Doenec/ecg-esp32/WhatsApp Image 2024-11-03 at 2.57.34 PM.jpeg

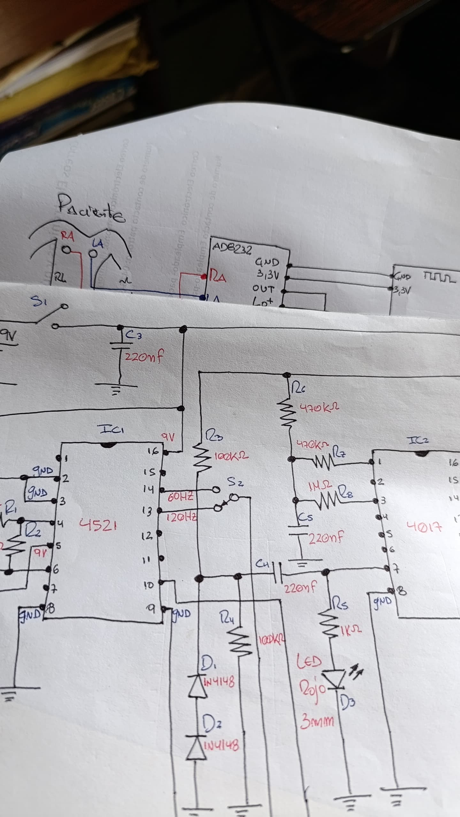
WhatsApp Image 2024-11-03 at 2.57.34 PM.jpeg
