Doenec/ecg-esp32/ECG V-0.2.jpg

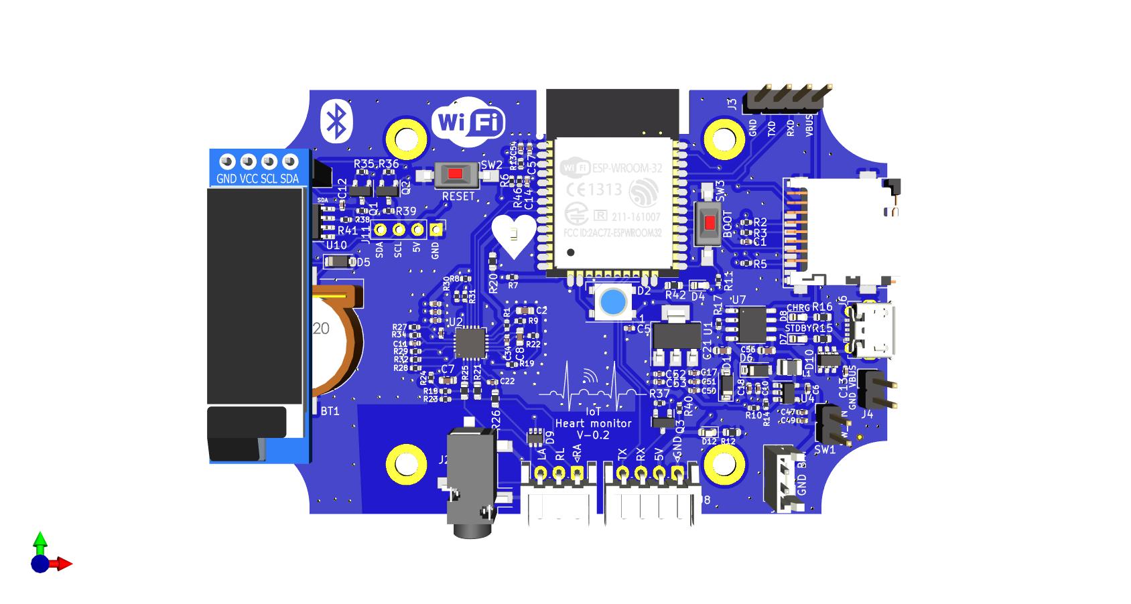
ECG V-0.2.jpg
