Doenec/ecg-esp32/ECG V-0.24.jpg

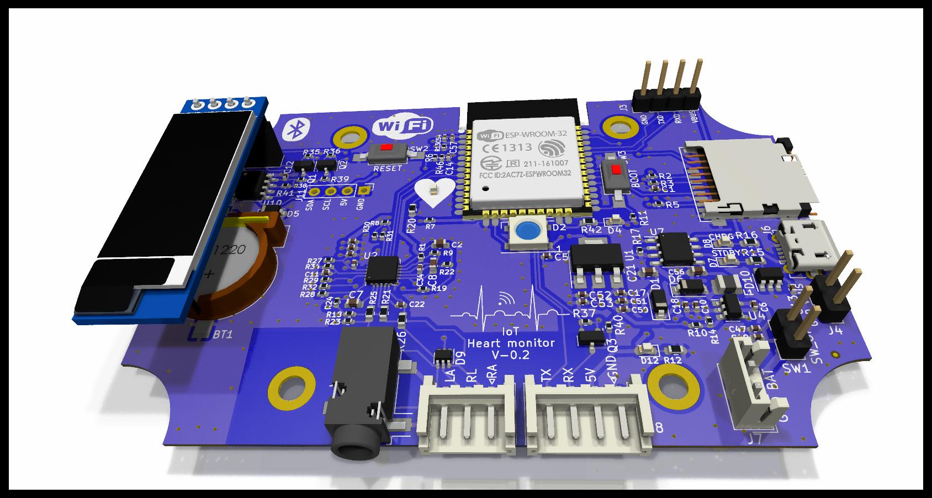
ECG V-0.24.jpg
