Doenec/ecg-esp32/untitled2.png

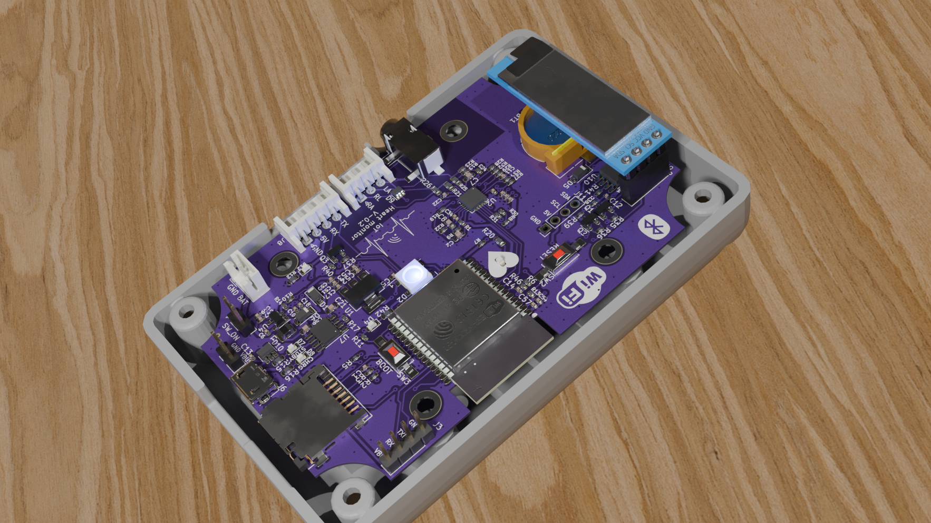
untitled2.png
