Doenec/ecg-esp32/untitled3.png

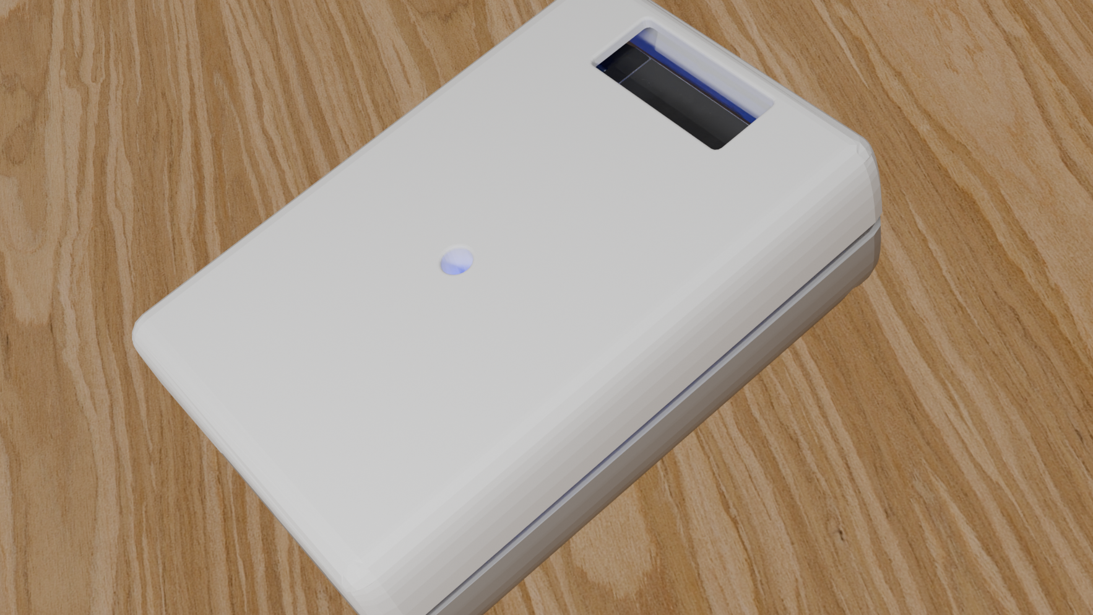
untitled3.png
