Doenec/ecg-esp32/untitled.png

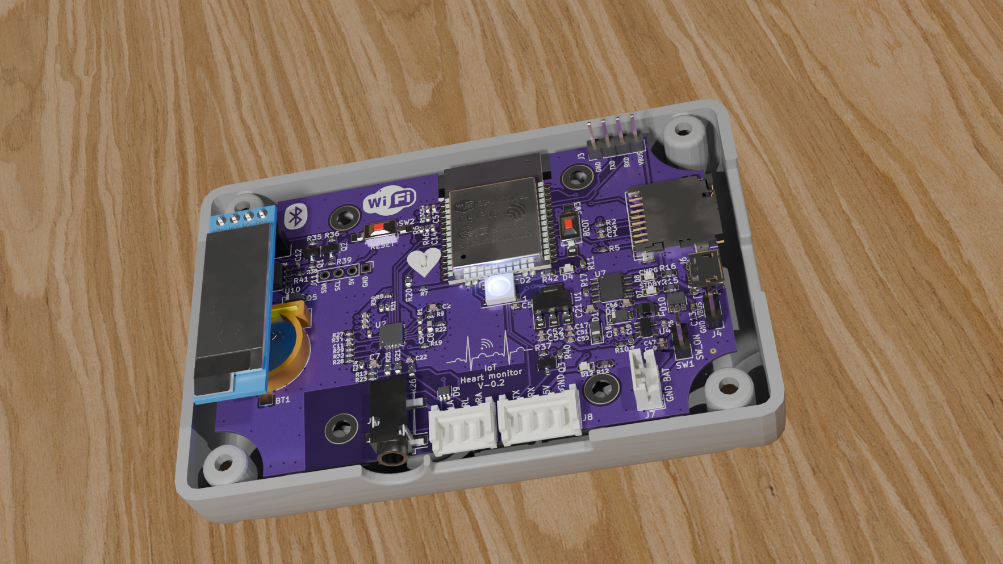
untitled.png
