Doenec/ecg-esp32/WhatsApp Image 2024-11-03 at 3.13.52 PM.jpeg

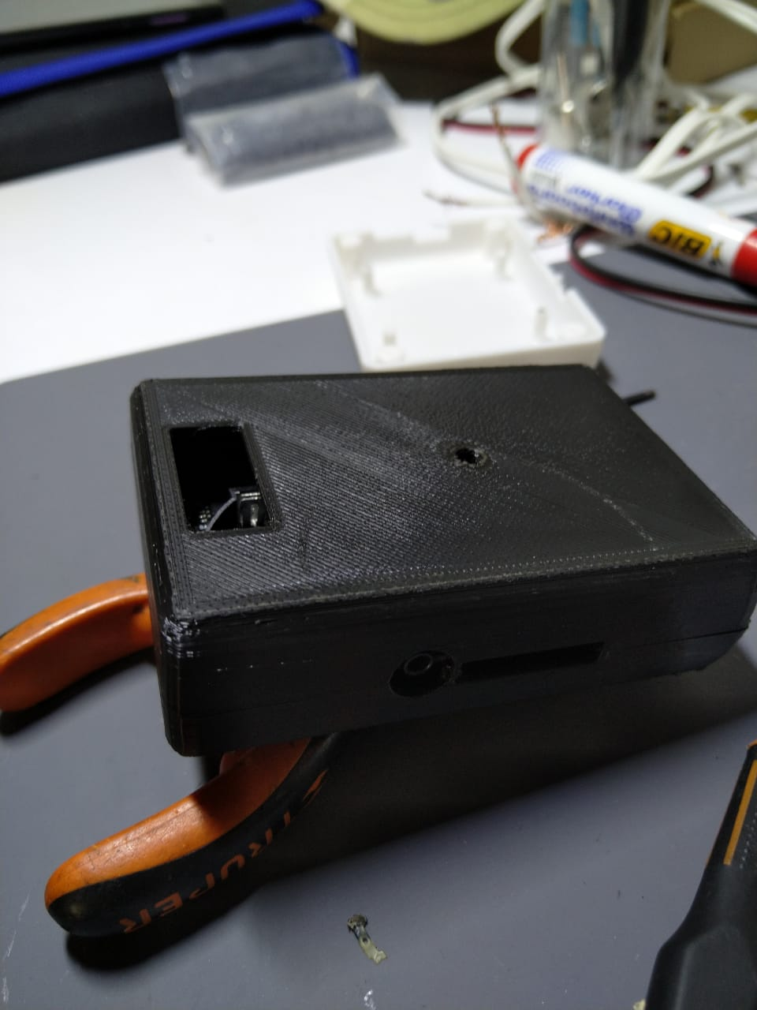
WhatsApp Image 2024-11-03 at 3.13.52 PM.jpeg
