Doenec/ecg-esp32/lower case ECG 8-1-23.STL

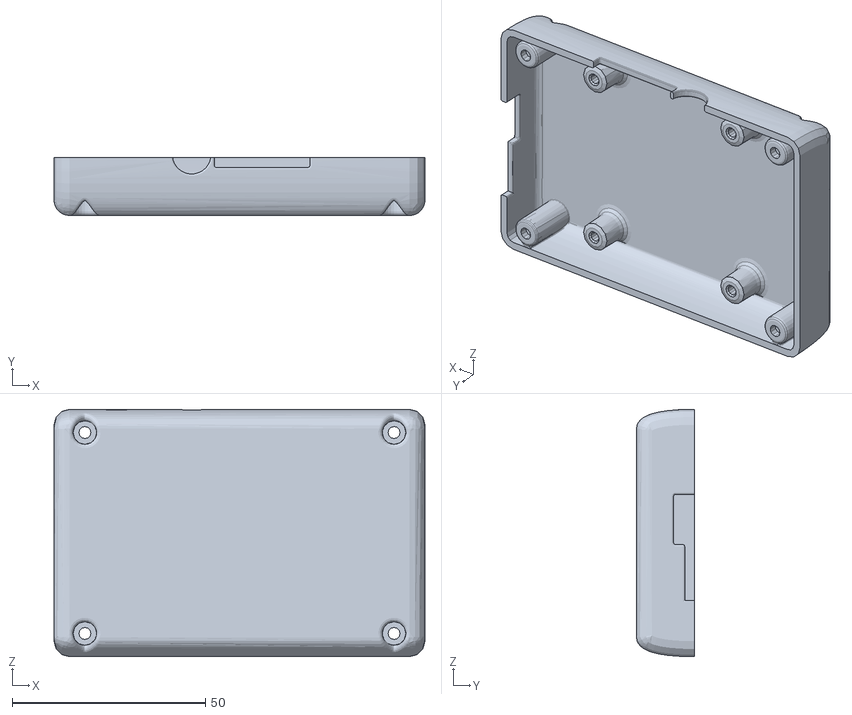
[picture p11: CAD file, 2024-11-03]
lower case ECG 8-1-23.STL
96.0 x 15.0 x 64.0
