Doenec/ecg-esp32/upper case ECG 8-1-23.STL

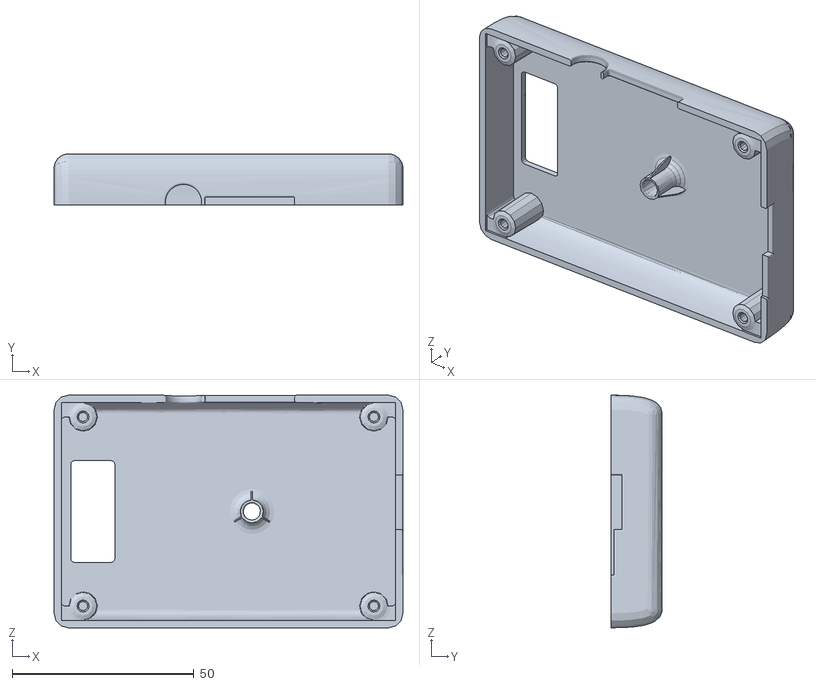
[picture p12: CAD file, 2024-11-03]
upper case ECG 8-1-23.STL
96.0 x 14.1 x 64.0
