Doenec/ecg-esp32/schematic esp32 ad8232.pdf

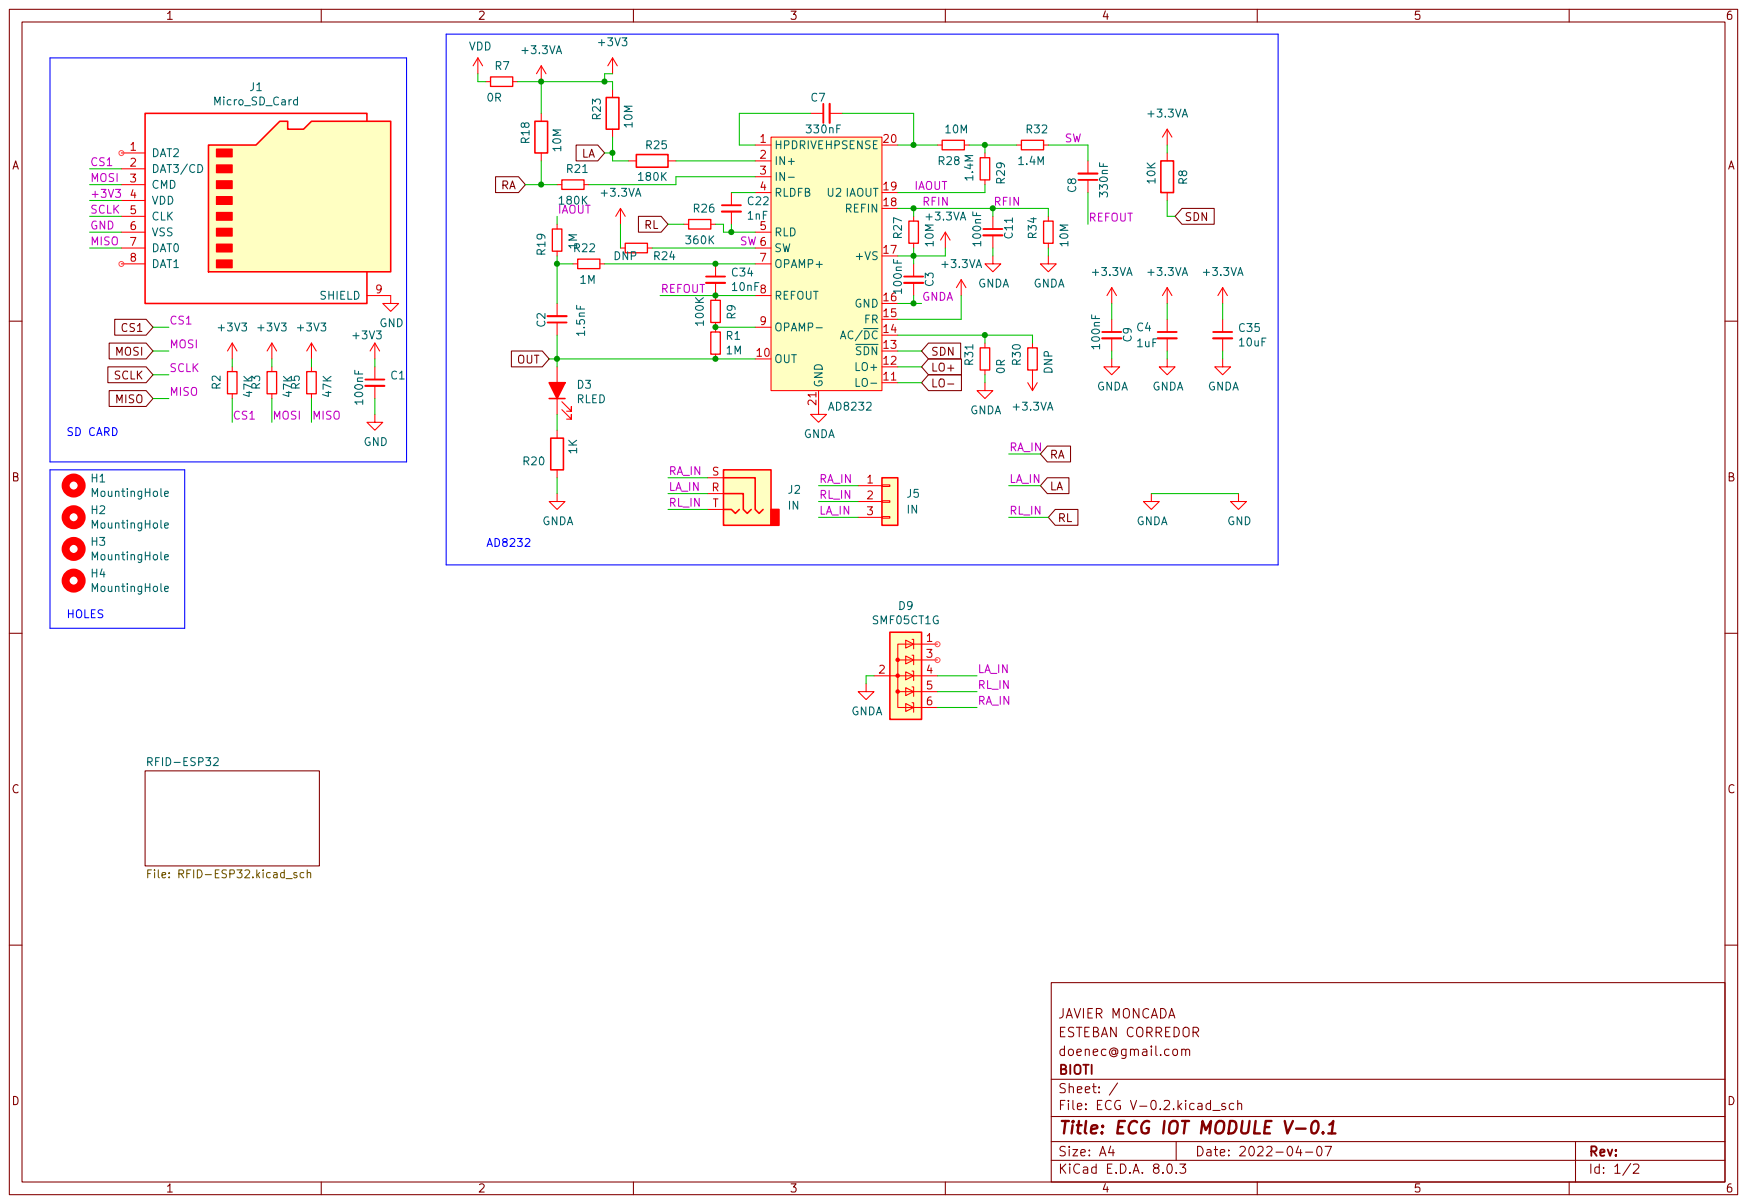
[picture p13: page 1]

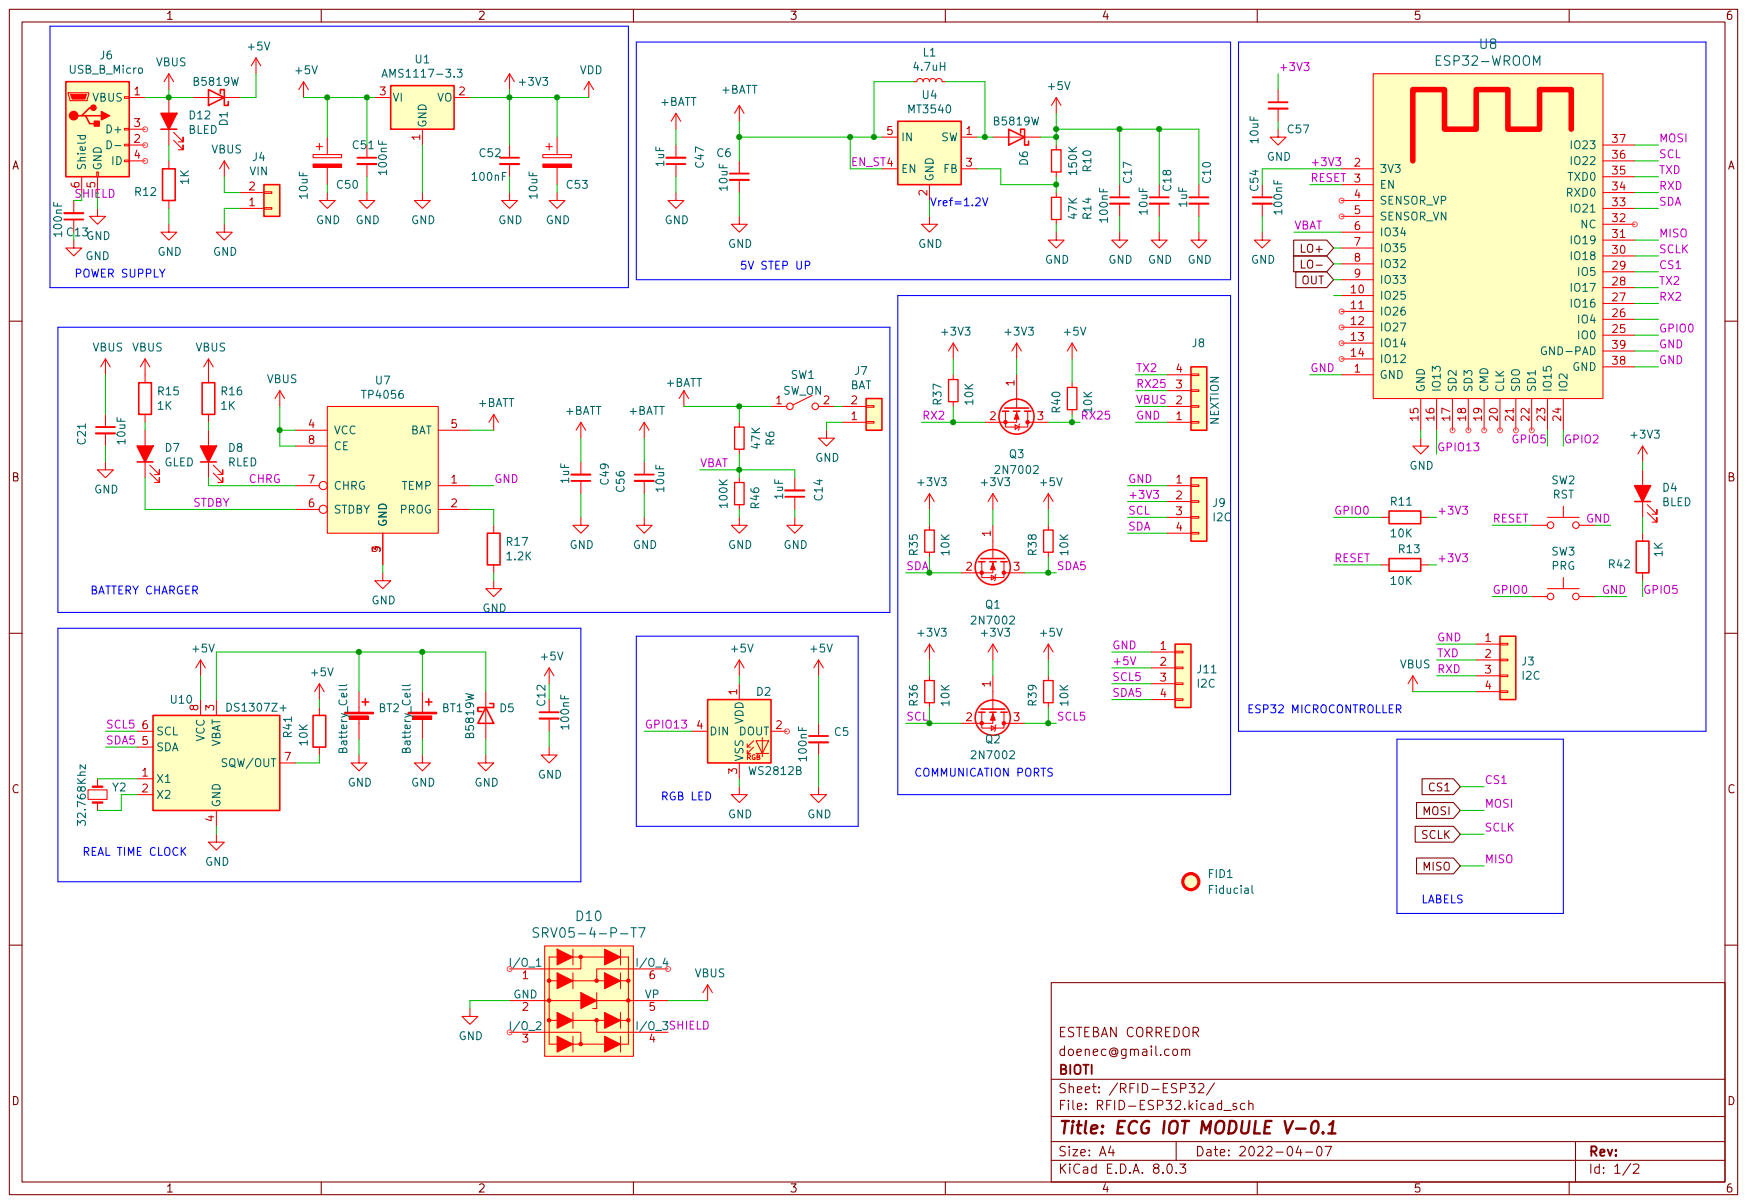
[picture p14: page 2]
