Doenec/ecg-esp32/ECG V-0.2/ECG V-0.2.kicad_pcb

## KiCad design ECG V-0.2/ECG V-0.2.kicad_pcb (2024-11-03)

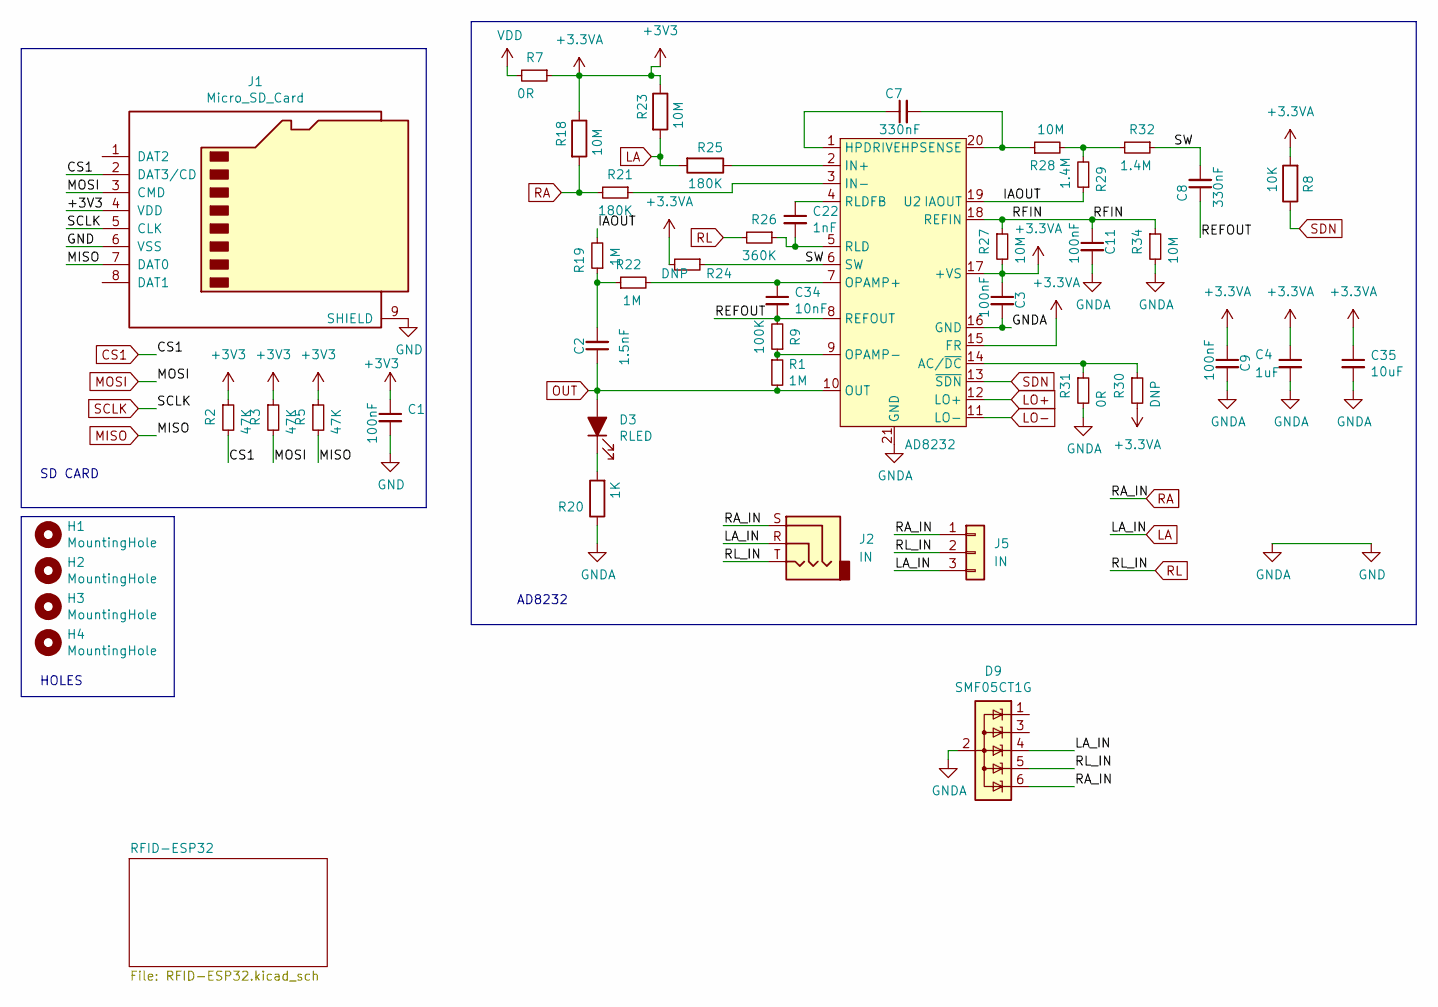
[picture p15: schematic ECG V-0.2.kicad_sch, ECG IOT MODULE V-0.1]

Parts:
C1, C3, C9, C11: 100nF; C_0402_1005Metric; MPN CL05B104KO5NNNC; LCSC-PN C1525
C2: 1.5nF; C_0603_1608Metric; MPN 0603B152K500NT; LCSC-PN C1595
C4: 1uF; C_0402_1005Metric; MPN CL05A105KA5NQNC; LCSC-PN C52923
C7, C8: 330nF; C_0603_1608Metric; MPN 0603B334K250NT; LCSC-PN C1615
C22: 1nF; C_0402_1005Metric; MPN 0402B102K500NT; LCSC-PN C1523
C34: 10nF; C_0402_1005Metric; MPN CL05B103KB5NNNC; LCSC-PN C15195
C35: 10uF; C_0402_1005Metric; MPN CL05A106MQ5NUNC; LCSC-PN C15525
D3: RLED; LED_0603_1608Metric; MPN KT-0603R; LCSC-PN C2286
D9: SMF05CT1G; SOT-363_SC-70-6; MPN SMF05CT1G; LCSC-PN C15879
H1, H2, H3, H4: MountingHole; MountingHole_3.2mm_M3_DIN965_Pad
J1: Micro_SD_Card; microSD; MPN TF PUSH; LCSC-PN C393941
J2: IN; PJ-320B; MPN PJ-320B; LCSC-PN C18594
J5: IN; JST_EH_S3B-EH_1x03_P2.50mm_Horizontal
R1, R19, R22: 1M; R_0402_1005Metric; MPN 0402WGF1004TCE; LCSC-PN C26083
R2, R3, R5: 47K; R_0402_1005Metric; MPN 0402WGF4702TCE; LCSC-PN C25792
R7, R31: 0R; R_0402_1005Metric; MPN 0402WGF0000TCE; LCSC-PN C17168
R8: 10K; R_0402_1005Metric; MPN 0402WGF1002TCE; LCSC-PN C25744
R9: 100K; R_0402_1005Metric; MPN 0402WGF1003TCE; LCSC-PN C25741
R18, R23, R27, R28, R34: 10M; R_0402_1005Metric; MPN 0402WGF1005TCE; LCSC-PN C26082
R20: 1K; R_0603_1608Metric; MPN 0603WAF1001T5E; LCSC-PN C21190
R21, R25: 180K; R_0603_1608Metric; MPN 0603WAF1803T5E; LCSC-PN C22827
R24, R30: DNP; R_0402_1005Metric
R26: 360K; R_0603_1608Metric; MPN 0603WAF3603T5E; LCSC-PN C23146
R29, R32: 1.4M; R_0402_1005Metric; MPN 0402WGF1404TCE; LCSC-PN C270644
U2: AD8232; LFCSP-20-1EP_4x4mm_P0.5mm_EP2.5x2.5mm_ThermalVias; MPN AD8232ACPZ-RL; LCSC-PN C652575

Connections:
+3.3VA: C1.1, C3.1, C4.1, C9.1, C35.1, J1.4 (VDD), R2.1, R3.1, R5.1, R7.1, R8.2, R18.1, R23.1, R24.2, R27.2, R30.2, U2.15 (FR), U2.17 (+VS); also elsewhere on the board
/IAOUT: R19.2, R29.1, U2.19 (IAOUT)
/REFOUT: C8.1, C34.2, R9.2, U2.8 (REFOUT)
/RFIN: C11.1, R27.1, R34.1, U2.18 (REFIN)
/SW: C8.2, R24.1, R32.1, U2.6 (SW)
CS1: J1.2 (DAT3/CD), R2.2; also elsewhere on the board
GND: C1.2, C3.2, C4.2, C9.2, C11.2, C35.2, D9.2 (A), J1.6 (VSS), J1.9 (SHIELD), J1.10, J1.11, J1.12, J1.13, R20.1, R31.2, R34.2, U2.16 (GND), U2.21 (GND); also elsewhere on the board
LA: D9.4 (K), J2.R, J5.3, R23.2, R25.2
LO+: U2.12 (LO+); also elsewhere on the board
LO-: U2.11 (LO-); also elsewhere on the board
MISO: J1.7 (DAT0), R5.2; also elsewhere on the board
MOSI: J1.3 (CMD), R3.2; also elsewhere on the board
unnamed: C2.2, R19.1, R22.1
unnamed: D3.1 (K), R20.2
unnamed: R28.2, R29.2, R32.2
unnamed: R30.1, R31.1, U2.14 (AC/~DC)
unnamed: C7.1, U2.1 (HPDRIVE)
unnamed: C7.2, R28.1, U2.20 (HPSENSE)
unnamed: R25.1, U2.2 (IN+)
unnamed: R21.1, U2.3 (IN-)
unnamed: C34.1, R22.2, U2.7 (OPAMP+)
unnamed: R1.1, R9.1, U2.9 (OPAMP-)
unnamed: C22.2, R26.1, U2.5 (RLD)
unnamed: C22.1, U2.4 (RLDFB)
OUT: C2.1, D3.2 (A), R1.2, U2.10 (OUT); also elsewhere on the board
RA: D9.6 (K), J2.S, J5.1, R18.2, R21.2
RL: D9.5 (K), J2.T, J5.2, R26.2
SCLK: J1.5 (CLK); also elsewhere on the board
SDN: R8.1, U2.13 (~SDN)
VDD: R7.2

Notes on the sheet:
AD8232
HOLES
SD CARD

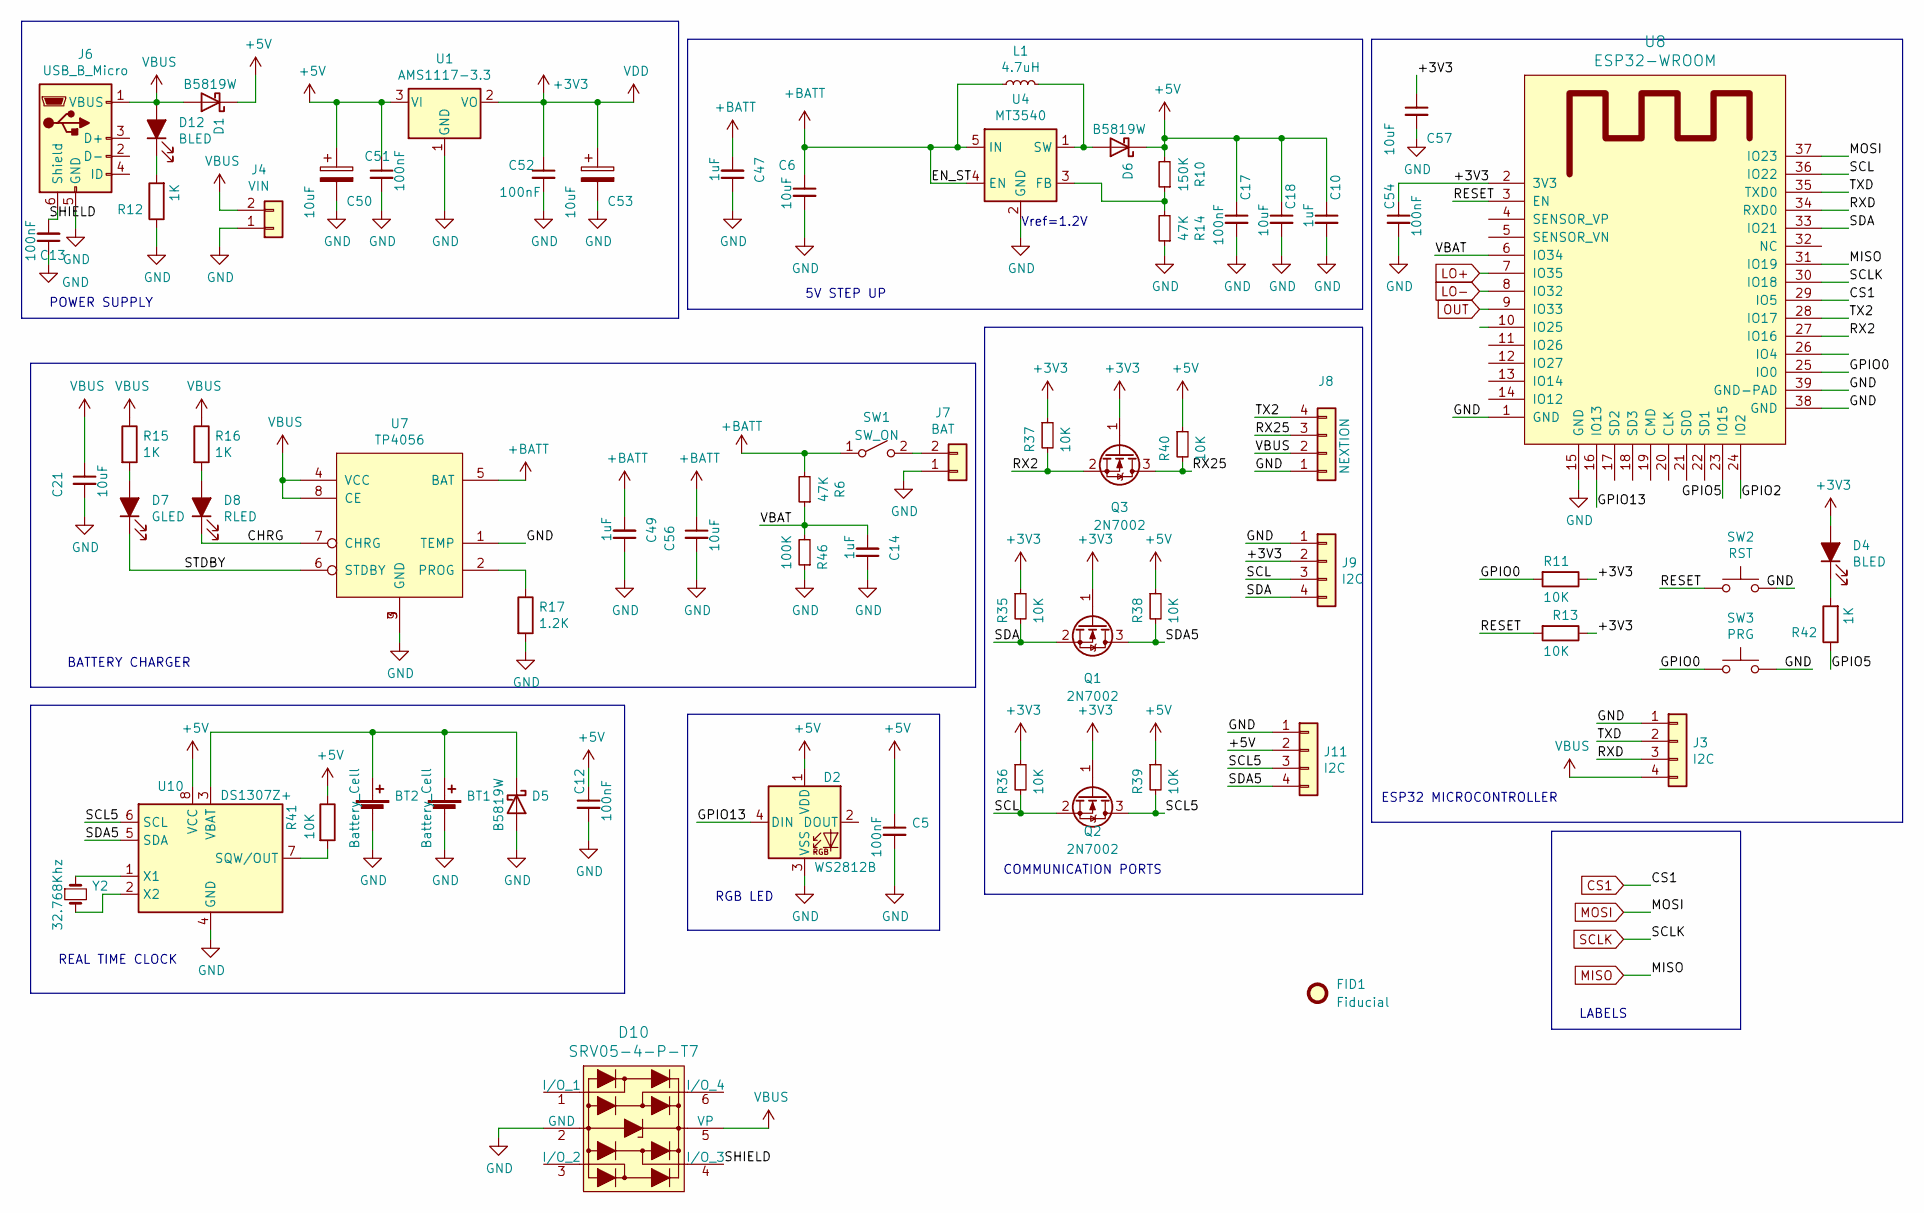
[picture p16: schematic RFID-ESP32.kicad_sch, ECG IOT MODULE V-0.1]

Parts:
BT1: Battery_Cell; cr1220-2; MPN CR1220-2; LCSC-PN C70381
BT2: Battery_Cell; PinHeader_1x02_P2.54mm_Vertical
C5, C12, C13, C17, C51, C52, C54: 100nF; C_0402_1005Metric; MPN CL05B104KO5NNNC; LCSC-PN C1525
C6, C18, C50, C53, C57: 10uF; C_0402_1005Metric; MPN CL05A106MQ5NUNC; LCSC-PN C15525
C10, C14, C47, C49: 1uF; C_0402_1005Metric; MPN CL05A105KA5NQNC; LCSC-PN C52923
C21, C56: 10uF; C_0603_1608Metric; MPN 0603X106K160NT; LCSC-PN C70225
D1, D5, D6: B5819W; D_SOD-123; MPN B5819W; LCSC-PN C8598
D2: WS2812B; LED_WS2812B_PLCC4_5.0x5.0mm_P3.2mm; MPN WS2812B-B; LCSC-PN C114586
D4, D12: BLED; LED_0603_1608Metric; MPN 19-217/BHC-ZL1M2RY/3T; LCSC-PN C72041
D7: GLED; LED_0603_1608Metric; MPN 19-217/GHC-YR1S2/3T; LCSC-PN C72043
D8: RLED; LED_0603_1608Metric; MPN KT-0603R; LCSC-PN C2286
D10: SRV05-4-P-T7; SOT-23-6; MPN SRV05-4-P-T7; Digi-Key_PN 1727-3578-1-ND
FID1: Fiducial; Fiducial_0.5mm_Mask1mm
J3, J11: I2C; PinHeader_1x04_P2.54mm_Vertical
J4: VIN; PinHeader_1x02_P2.54mm_Vertical
J6: USB_B_Micro; USB_Micro-B_Molex-105017-0001; MPN 1050170001; LCSC-PN C136000
J7: BAT; JST_EH_B2B-EH-A_1x02_P2.50mm_Vertical
J8: NEXTION; JST_EH_S4B-EH_1x04_P2.50mm_Horizontal
J9: I2C; OLED_I2C_091
L1: 4.7uH; L_1008_2520Metric; MPN LQM2HPN4R7MG0L; LCSC-PN C82314
Q1, Q2, Q3: 2N7002; SOT-23; MPN 2N7002; LCSC-PN C8545
R6, R14: 47K; R_0402_1005Metric; MPN 0402WGF4702TCE; LCSC-PN C25792
R10: 150K; R_0402_1005Metric; MPN 0402WGF1503TCE; LCSC-PN C25755
R11, R13, R35, R36, R37, R38, R39, R40, R41: 10K; R_0402_1005Metric; MPN 0402WGF1002TCE; LCSC-PN C25744
R12, R15, R16, R42: 1K; R_0603_1608Metric; MPN 0603WAF1001T5E; LCSC-PN C21190
R17: 1.2K; R_0402_1005Metric; MPN 0603WAF1201T5E; LCSC-PN C22765
R46: 100K; R_0402_1005Metric; MPN 0402WGF1003TCE; LCSC-PN C25741
SW1: SW_ON; PinHeader_1x02_P2.54mm_Vertical
SW2: RST; SW_SPST_FSMSM; MPN K2-1107ST-A4DW-06; LCSC-PN C118141
SW3: PRG; SW_SPST_FSMSM; MPN K2-1107ST-A4DW-06; LCSC-PN C118141
U1: AMS1117-3.3; SOT-223-3_TabPin2; MPN AMS1117-3.3; LCSC-PN C6186
U4: MT3540; SOT-23-5; MPN MT3540; LCSC-PN C181744
U7: TP4056; HSOP-8-1EP_3.9x4.9mm_P1.27mm_EP2.41x3.1mm_ThermalVias; MPN TP4056-42-ESOP8; LCSC-PN C16581
U8: ESP32-WROOM; ESP32-WROOM-Modif; MPN ESP32-WROOM-32E(4MB); LCSC-PN C82899
U10: DS1307Z+; SOIC-8_3.9x4.9mm_P1.27mm; MPN DS1307Z+T&R; LCSC-PN C9868
Y2: 32.768Khz; Crystal_SMD_G8-2Pin_3.2x1.5mm; MPN Q13FC1350000400; LCSC-PN C32346

Connections:
+3.3VA: C52.1, C53.1, C54.1, C57.1, D4.2 (A), J9.2, Q1.1 (G), Q2.1 (G), Q3.1 (G), R11.1, R13.1, R35.1, R36.1, R37.1, U1.2 (VO), U8.2 (3V3); also elsewhere on the board
+5V: C5.1, C10.1, C12.1, C17.1, C18.1, C50.1, C51.1, D1.1 (K), D2.1 (VDD), D6.1 (K), J11.2, R10.2, R38.1, R39.1, R40.1, R41.1, U1.3 (VI), U10.8 (VCC)
+BATT: C6.1, C47.2, C49.2, C56.1, L1.1, R6.2, SW1.1 (A), U4.4 (EN), U4.5 (IN), U7.5 (BAT)
/RFID-ESP32/CHRG: D8.1 (K), U7.7 (CHRG)
/RFID-ESP32/GPIO0: R11.2, SW3.1, U8.25 (IO0)
/RFID-ESP32/GPIO2: U8.24 (IO2)
/RFID-ESP32/GPIO5: R42.1, U8.23 (IO15)
/RFID-ESP32/GPIO13: D2.4 (DIN), U8.16 (IO13)
/RFID-ESP32/RESET: R13.2, SW2.1, U8.3 (EN)
/RFID-ESP32/RX2: Q3.2 (S), R37.2, U8.27 (IO16)
/RFID-ESP32/RX25: J8.3, Q3.3 (D), R40.2
/RFID-ESP32/RXD: J3.3, U8.34 (RXD0)
/RFID-ESP32/SCL: J9.3, Q2.2 (S), R36.2, U8.36 (IO22)
/RFID-ESP32/SCL5: J11.3, Q2.3 (D), R39.2, U10.6 (SCL)
/RFID-ESP32/SDA: J9.4, Q1.2 (S), R35.2, U8.33 (IO21)
/RFID-ESP32/SDA5: J11.4, Q1.3 (D), R38.2, U10.5 (SDA)
/RFID-ESP32/SHIELD: C13.2, D10.4 (I/O_3), J6.6 (Shield)
/RFID-ESP32/STDBY: D7.1 (K), U7.6 (STDBY)
/RFID-ESP32/TX2: J8.4, U8.28 (IO17)
/RFID-ESP32/TXD: J3.2, U8.35 (TXD0)
/RFID-ESP32/VBAT: C14.2, R6.1, R46.2, U8.6 (IO34)
CS1: U8.29 (IO5); also elsewhere on the board
GND: BT1.2 (-), BT2.2 (-), C5.2, C6.2, C10.2, C12.2, C13.1, C14.1, C17.2, C18.2, C21.2, C47.1, C49.1, C50.2, C51.2, C52.2, C53.2, C54.2, C56.2, C57.2, D2.3 (VSS), D5.2 (A), D10.2 (GND), J3.1, J4.1, J6.5 (GND), J7.1, J8.1, J9.1, J11.1, R12.1, R14.1, R17.2, R46.1, SW2.2, SW3.2, U1.1 (GND), U4.2 (GND), U7.1 (TEMP), U7.3 (GND), U7.9 (GND), U8.1 (GND), U8.15 (GND), U8.38 (GND), U8.39 (GND-PAD), U10.4 (GND); also elsewhere on the board
LO+: U8.7 (IO35); also elsewhere on the board
LO-: U8.8 (IO32); also elsewhere on the board
MISO: U8.31 (IO19); also elsewhere on the board
MOSI: U8.37 (IO23); also elsewhere on the board
unnamed: BT1.1 (+), BT2.1 (+), D5.1 (K), U10.3 (VBAT)
unnamed: D4.1 (K), R42.2
unnamed: D6.2 (A), L1.2, U4.1 (SW)
unnamed: D7.2 (A), R15.2
unnamed: D8.2 (A), R16.2
unnamed: D12.1 (K), R12.2
unnamed: J7.2, SW1.2 (B)
unnamed: R10.1, R14.2, U4.3 (FB)
unnamed: R17.1, U7.2 (PROG)
unnamed: R41.2, U10.7 (SQW/OUT)
unnamed: U10.1 (X1), Y2.1
unnamed: U10.2 (X2), Y2.2
OUT: U8.9 (IO33); also elsewhere on the board
SCLK: U8.30 (IO18); also elsewhere on the board
VBUS: C21.1, D1.2 (A), D10.5 (VP), D12.2 (A), J3.4, J4.2, J6.1 (VBUS), J8.2, R15.1, R16.1, U7.4 (VCC), U7.8 (CE)

Notes on the sheet:
ESP32 MICROCONTROLLER
LABELS
REAL TIME CLOCK
COMMUNICATION PORTS
POWER SUPPLY
5V STEP UP
BATTERY CHARGER
Vref=1.2V
RGB LED

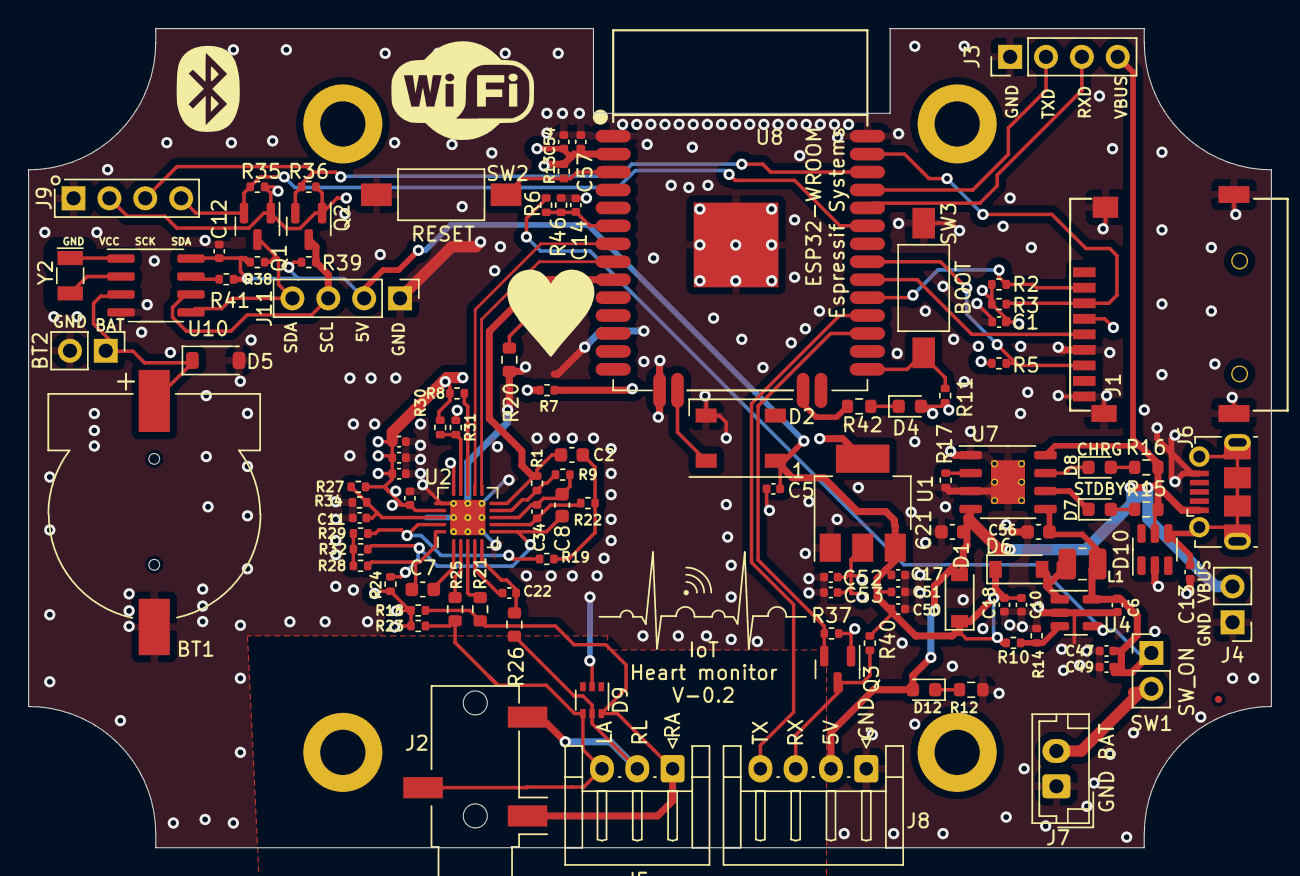
[picture p17: board ECG V-0.2.kicad_pcb from above]

Board: 4 copper layers, 88.0 x 58.0 mm, 112 parts (0 on the bottom side), 61 nets.
